46nori/PointController/16CH-PointController/PointController.kicad_sch

## KiCad design 16CH-PointController/PointController.kicad_sch (2023-10-30)

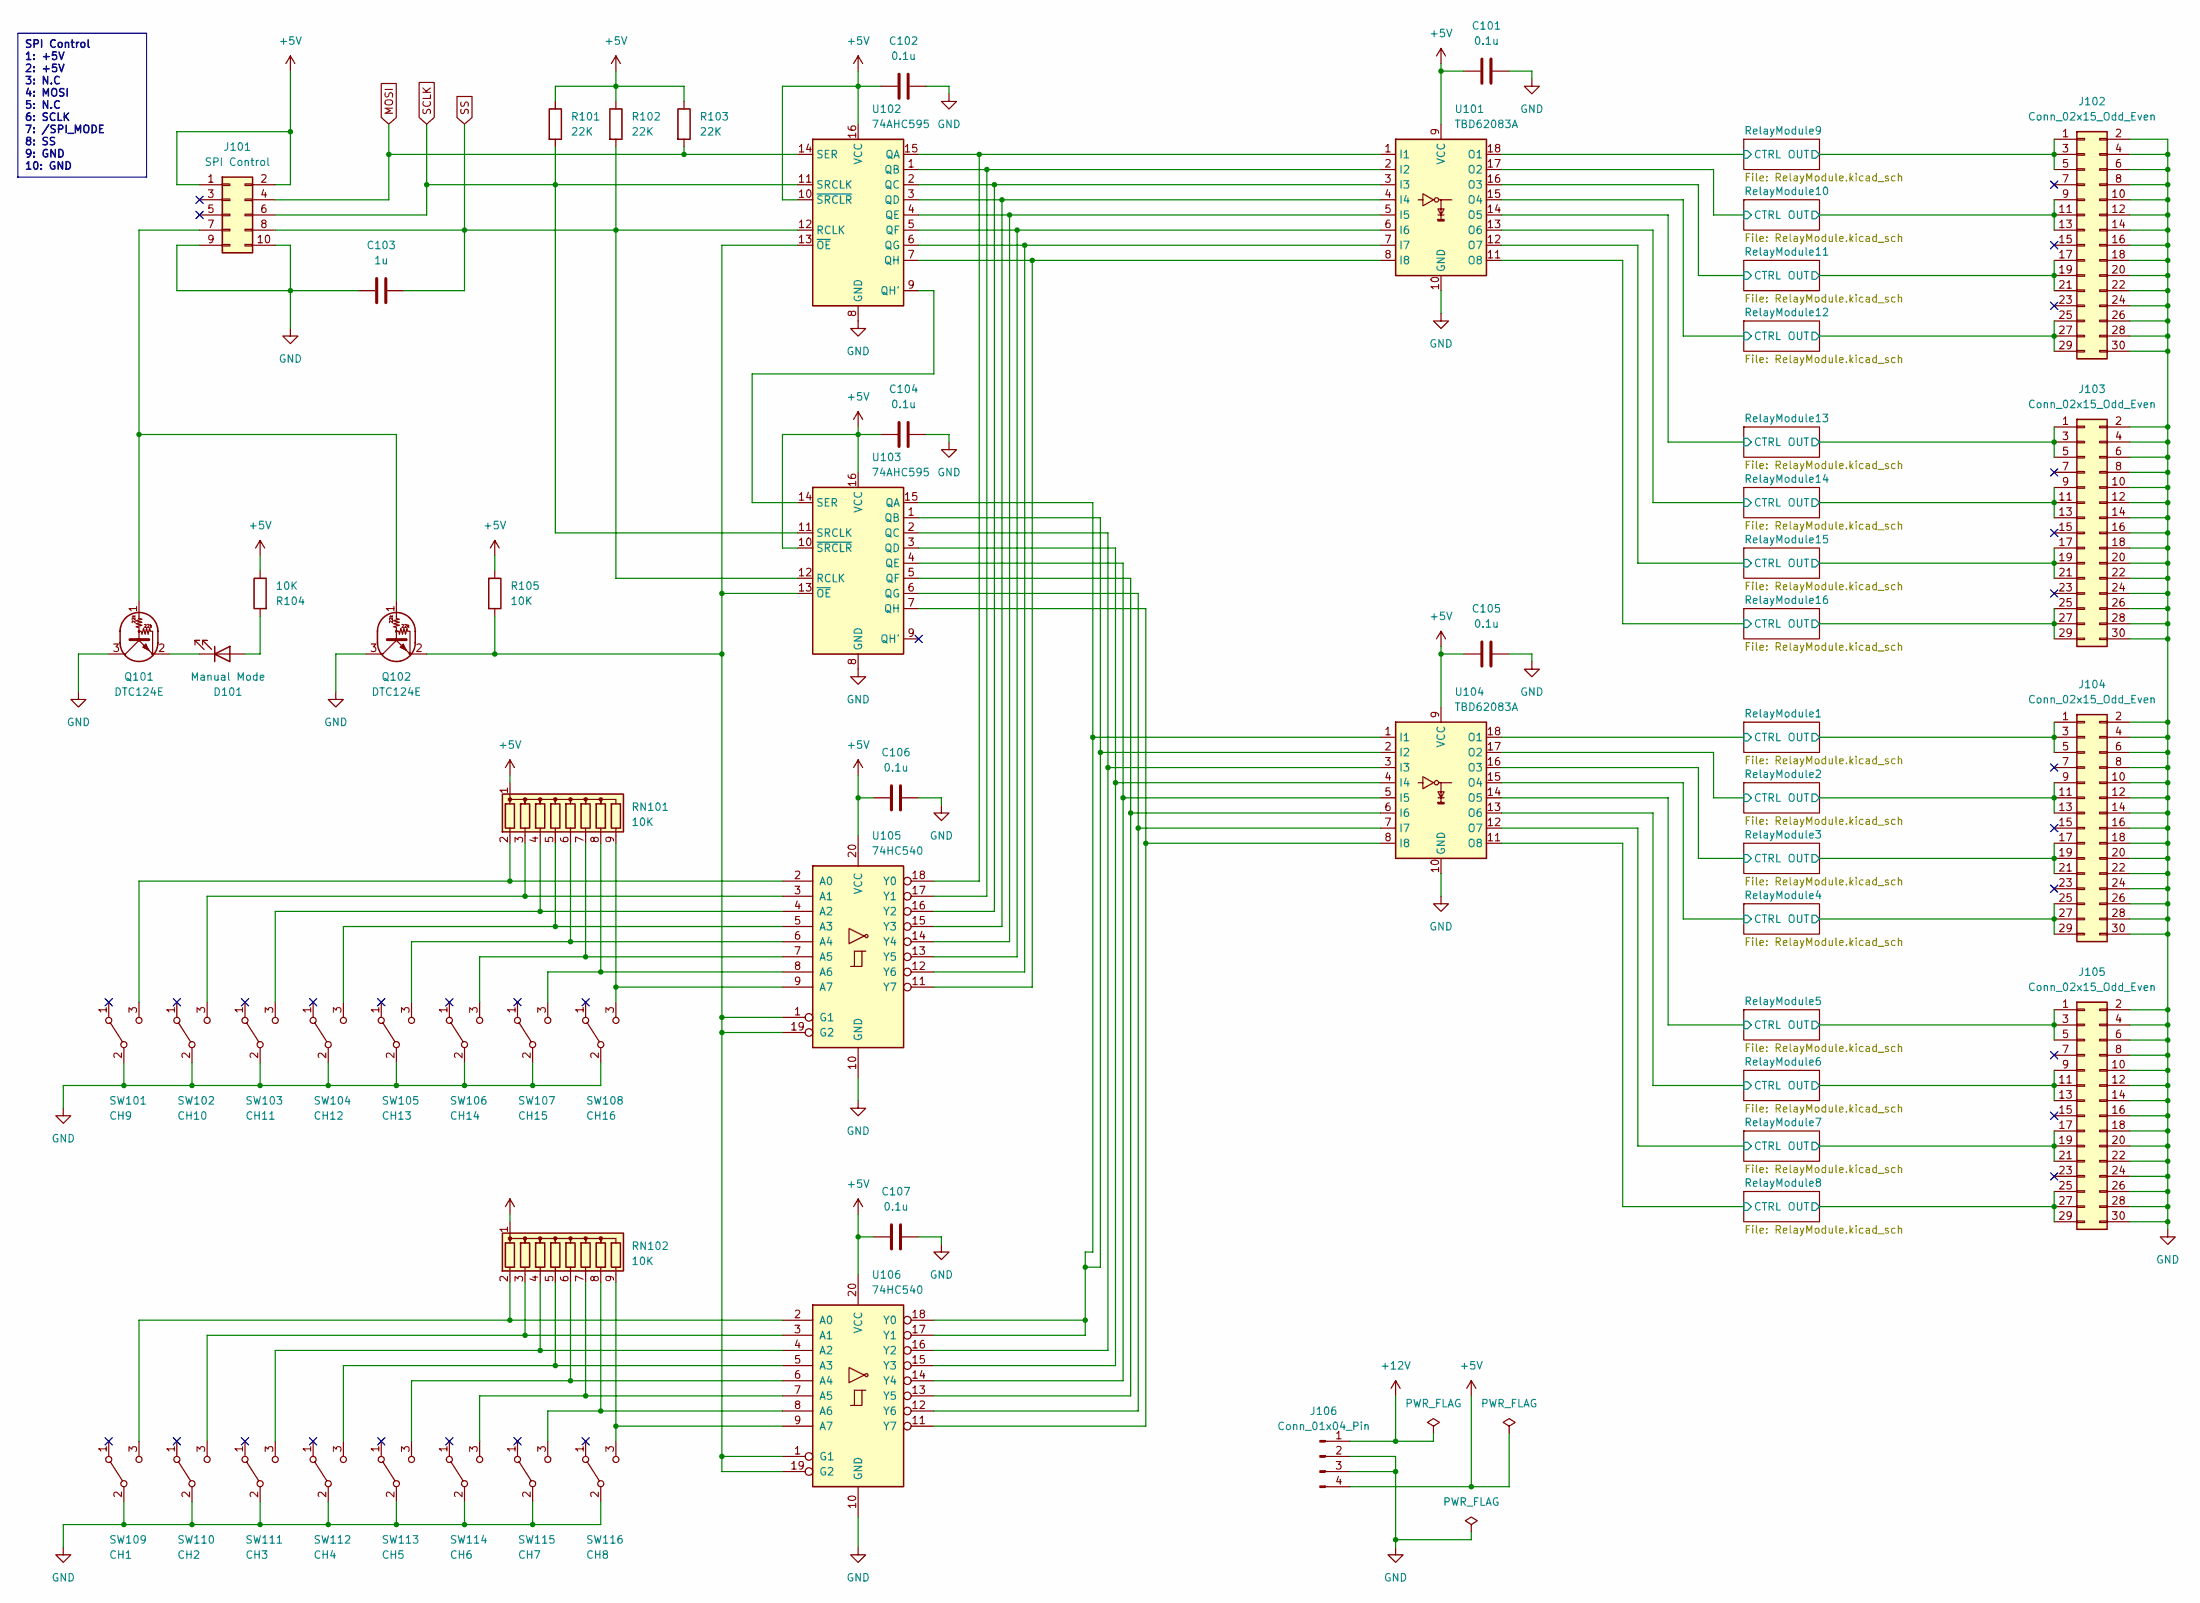
[picture p1: schematic PointController.kicad_sch]

Parts:
C101, C102, C104, C105, C106, C107: 0.1u; C_Rect_L4.0mm_W2.5mm_P2.50mm
C103: 1u; C_Rect_L4.0mm_W2.5mm_P2.50mm
D101: Manual Mode; LED_D3.0mm
J101: SPI Control; PinHeader_2x05_P2.54mm_Vertical
J102, J103, J104, J105: Conn_02x15_Odd_Even; PinHeader_2x15_P2.54mm_Vertical
J106: Conn_01x04_Pin; TE_MATE-N-LOK_350211-1_1x04_P5.08mm_Vertical
Q101, Q102: DTC124E; TO-92S
R101, R102, R103: 22K; R_Axial_DIN0204_L3.6mm_D1.6mm_P7.62mm_Horizontal
R104, R105: 10K; R_Axial_DIN0204_L3.6mm_D1.6mm_P7.62mm_Horizontal
RN101, RN102: 10K; R_Array_SIP9
SW101: CH9; 2MS1-T1-B4-VS2-Q-E-S
SW102: CH10; 2MS1-T1-B4-VS2-Q-E-S
SW103: CH11; 2MS1-T1-B4-VS2-Q-E-S
SW104: CH12; 2MS1-T1-B4-VS2-Q-E-S
SW105: CH13; 2MS1-T1-B4-VS2-Q-E-S
SW106: CH14; 2MS1-T1-B4-VS2-Q-E-S
SW107: CH15; 2MS1-T1-B4-VS2-Q-E-S
SW108: CH16; 2MS1-T1-B4-VS2-Q-E-S
SW109: CH1; 2MS1-T1-B4-VS2-Q-E-S
SW110: CH2; 2MS1-T1-B4-VS2-Q-E-S
SW111: CH3; 2MS1-T1-B4-VS2-Q-E-S
SW112: CH4; 2MS1-T1-B4-VS2-Q-E-S
SW113: CH5; 2MS1-T1-B4-VS2-Q-E-S
SW114: CH6; 2MS1-T1-B4-VS2-Q-E-S
SW115: CH7; 2MS1-T1-B4-VS2-Q-E-S
SW116: CH8; 2MS1-T1-B4-VS2-Q-E-S
U101, U104: TBD62083A; DIP-18_W7.62mm_Socket
U102, U103: 74AHC595; DIP-16_W7.62mm_Socket
U105, U106: 74HC540; DIP-20_W7.62mm_Socket

Connections:
+5V: C101.1, C102.2, C104.2, C105.1, C106.2, C107.2, J101.1, J101.2, J106.4, R101.1, R102.1, R103.1, R104.1, R105.1, RN101.1 (common), RN102.1 (common), U101.9 (VCC), U102.10 (~SRCLR), U102.16 (VCC), U103.10 (~SRCLR), U103.16 (VCC), U104.9 (VCC), U105.20 (VCC), U106.20 (VCC)
+12V: J106.1
CTRL: U101.11 (O8), U101.12 (O7), U101.13 (O6), U101.14 (O5), U101.15 (O4), U101.16 (O3), U101.17 (O2), U101.18 (O1), U104.11 (O8), U104.12 (O7), U104.13 (O6), U104.14 (O5), U104.15 (O4), U104.16 (O3), U104.17 (O2), U104.18 (O1)
GND: C101.2, C102.1, C103.1, C104.1, C105.2, C106.1, C107.1, J101.9, J101.10, J102.2, J102.4, J102.6, J102.8, J102.10, J102.12, J102.14, J102.16, J102.18, J102.20, J102.22, J102.24, J102.26, J102.28, J102.30, J103.2, J103.4, J103.6, J103.8, J103.10, J103.12, J103.14, J103.16, J103.18, J103.20, J103.22, J103.24, J103.26, J103.28, J103.30, J104.2, J104.4, J104.6, J104.8, J104.10, J104.12, J104.14, J104.16, J104.18, J104.20, J104.22, J104.24, J104.26, J104.28, J104.30, J105.2, J105.4, J105.6, J105.8, J105.10, J105.12, J105.14, J105.16, J105.18, J105.20, J105.22, J105.24, J105.26, J105.28, J105.30, J106.2, J106.3, Q101.3 (C), Q102.3 (C), SW101.2 (B), SW102.2 (B), SW103.2 (B), SW104.2 (B), SW105.2 (B), SW106.2 (B), SW107.2 (B), SW108.2 (B), SW109.2 (B), SW110.2 (B), SW111.2 (B), SW112.2 (B), SW113.2 (B), SW114.2 (B), SW115.2 (B), SW116.2 (B), U101.10 (GND), U102.8 (GND), U103.8 (GND), U104.10 (GND), U105.10 (GND), U106.10 (GND)
MOSI: J101.4, R103.2, U102.14 (SER)
unnamed: D101.1 (K), Q101.2 (E)
unnamed: D101.2 (A), R104.2
unnamed: J101.7, Q101.1 (B), Q102.1 (B)
unnamed: Q102.2 (E), R105.2, U102.13 (~OE), U103.13 (~OE), U105.1 (G1), U105.19 (G2), U106.1 (G1), U106.19 (G2)
unnamed: RN101.2 (R1), SW101.3 (C), U105.2 (A0)
unnamed: RN101.3 (R2), SW102.3 (C), U105.3 (A1)
unnamed: RN101.4 (R3), SW103.3 (C), U105.4 (A2)
unnamed: RN101.5 (R4), SW104.3 (C), U105.5 (A3)
unnamed: RN101.6 (R5), SW105.3 (C), U105.6 (A4)
unnamed: RN101.7 (R6), SW106.3 (C), U105.7 (A5)
unnamed: RN101.8 (R7), SW107.3 (C), U105.8 (A6)
unnamed: RN101.9 (R8), SW108.3 (C), U105.9 (A7)
unnamed: RN102.2 (R1), SW109.3 (C), U106.2 (A0)
unnamed: RN102.3 (R2), SW110.3 (C), U106.3 (A1)
unnamed: RN102.4 (R3), SW111.3 (C), U106.4 (A2)
unnamed: RN102.5 (R4), SW112.3 (C), U106.5 (A3)
unnamed: RN102.6 (R5), SW113.3 (C), U106.6 (A4)
unnamed: RN102.7 (R6), SW114.3 (C), U106.7 (A5)
unnamed: RN102.8 (R7), SW115.3 (C), U106.8 (A6)
unnamed: RN102.9 (R8), SW116.3 (C), U106.9 (A7)
unnamed: U101.1 (I1), U102.15 (QA), U105.18 (Y0)
unnamed: U101.2 (I2), U102.1 (QB), U105.17 (Y1)
unnamed: U101.3 (I3), U102.2 (QC), U105.16 (Y2)
unnamed: U101.4 (I4), U102.3 (QD), U105.15 (Y3)
unnamed: U101.5 (I5), U102.4 (QE), U105.14 (Y4)
unnamed: U101.6 (I6), U102.5 (QF), U105.13 (Y5)
unnamed: U101.7 (I7), U102.6 (QG), U105.12 (Y6)
unnamed: U101.8 (I8), U102.7 (QH), U105.11 (Y7)
unnamed: U102.9 (QH'), U103.14 (SER)
unnamed: U103.1 (QB), U103.15 (QA), U104.1 (I1), U104.2 (I2), U106.17 (Y1), U106.18 (Y0)
unnamed: U103.2 (QC), U104.3 (I3), U106.16 (Y2)
unnamed: U103.3 (QD), U104.4 (I4), U106.15 (Y3)
unnamed: U103.4 (QE), U104.5 (I5), U106.14 (Y4)
unnamed: U103.5 (QF), U104.6 (I6), U106.13 (Y5)
unnamed: U103.6 (QG), U104.7 (I7), U106.12 (Y6)
unnamed: U103.7 (QH), U104.8 (I8), U106.11 (Y7)
OUT: J102.1, J102.3, J102.5, J102.9, J102.11, J102.13, J102.17, J102.19, J102.21, J102.25, J102.27, J102.29, J103.1, J103.3, J103.5, J103.9, J103.11, J103.13, J103.17, J103.19, J103.21, J103.25, J103.27, J103.29, J104.1, J104.3, J104.5, J104.9, J104.11, J104.13, J104.17, J104.19, J104.21, J104.25, J104.27, J104.29, J105.1, J105.3, J105.5, J105.9, J105.11, J105.13, J105.17, J105.19, J105.21, J105.25, J105.27, J105.29
SCLK: J101.6, R101.2, U102.11 (SRCLK), U103.11 (SRCLK)
SS: C103.2, J101.8, R102.2, U102.12 (RCLK), U103.12 (RCLK)

Notes on the sheet:
SPI Control 1: +5V 2: +5V 3: N.C 4: MOSI 5: N.C 6: SCLK 7: /SPI_MODE 8: SS 9: GND 10: GND
