46nori/PointController/16CH-PointController/RelayModule.kicad_sch

## KiCad design 16CH-PointController/RelayModule.kicad_sch (2023-10-30)

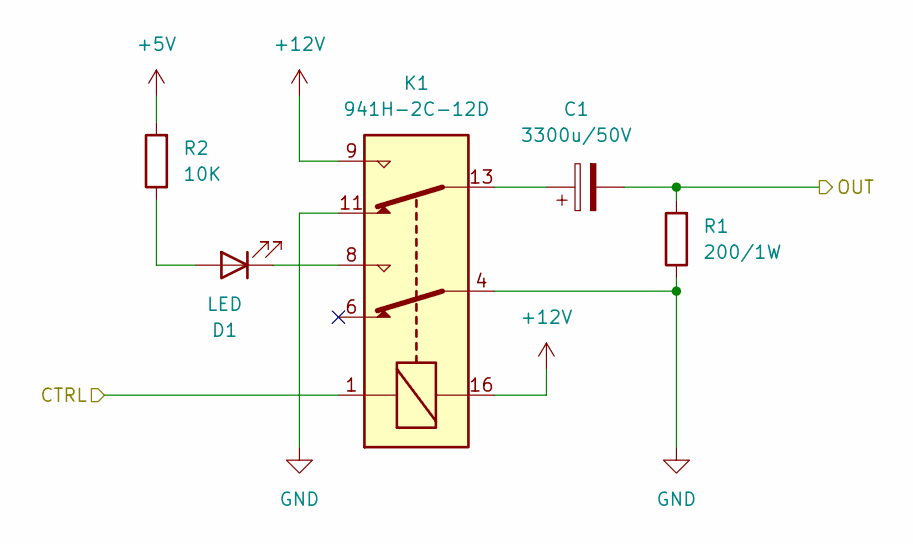
[picture p2: schematic RelayModule.kicad_sch]

Parts:
C1: 3300u/50V; CP_Radial_D18.0mm_P7.50mm
D1: LED; LED_D3.0mm
K1: 941H-2C-12D; Relay_DPDT_Omron_G5V-2
R1: 200/1W; R_Axial_DIN0414_L11.9mm_D4.5mm_P20.32mm_Horizontal
R2: 10K; R_Axial_DIN0204_L3.6mm_D1.6mm_P7.62mm_Horizontal

Connections:
+5V: R2.2
+12V: K1.9, K1.16
CTRL: K1.1
GND: K1.4, K1.11, R1.1
unnamed: C1.1, K1.13
unnamed: D1.1 (K), K1.8
unnamed: D1.2 (A), R2.1
OUT: C1.2, R1.2
